RainH8/classic-trackball_1.5/hardware/Mechanicals-BTU-Mod/STL/Ploopy Classic V1.5 BTU/PloopyBTU_RevE_Buttons_main.stl

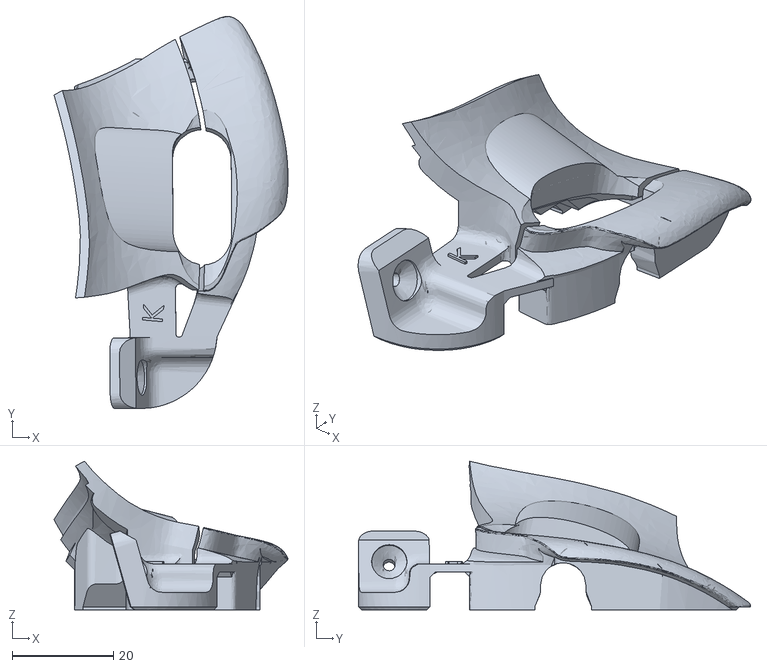
[picture p1: CAD file, 2026-01-17]
hardware/Mechanicals-BTU-Mod/STL/Ploopy Classic V1.5 BTU/PloopyBTU_RevE_Buttons_main.stl
46.3 x 77.6 x 29.4
