RainH8/classic-trackball_1.5/hardware/Mechanicals-BTU-Mod/STL/Ploopy Classic V1.5 BTU/PloopyBTU_RevE_Buttons_small.stl

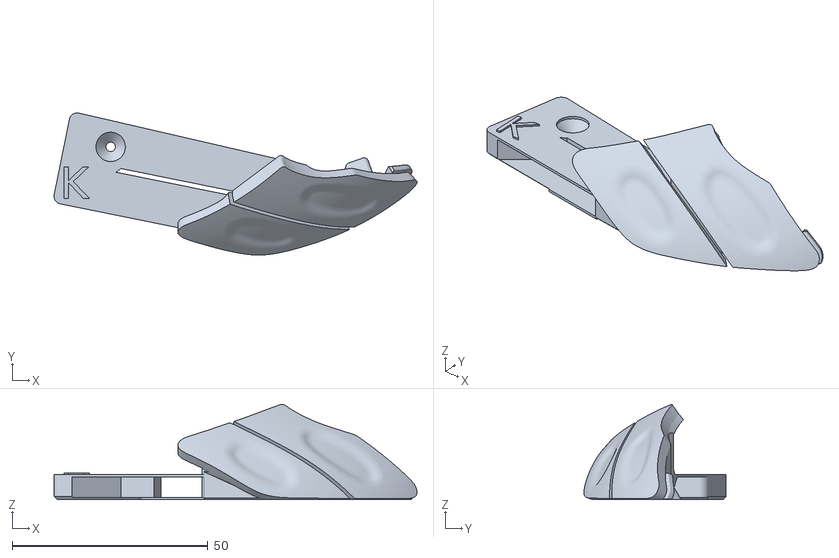
[picture p2: CAD file, 2026-01-17]
hardware/Mechanicals-BTU-Mod/STL/Ploopy Classic V1.5 BTU/PloopyBTU_RevE_Buttons_small.stl
92.8 x 36.3 x 24.3
