RainH8/classic-trackball_1.5/hardware/Mechanicals-BTU-Mod/STL/Ploopy Classic V1.5 BTU/PloopyBTU_RevE_Bottom_Shell-Wedge.stl

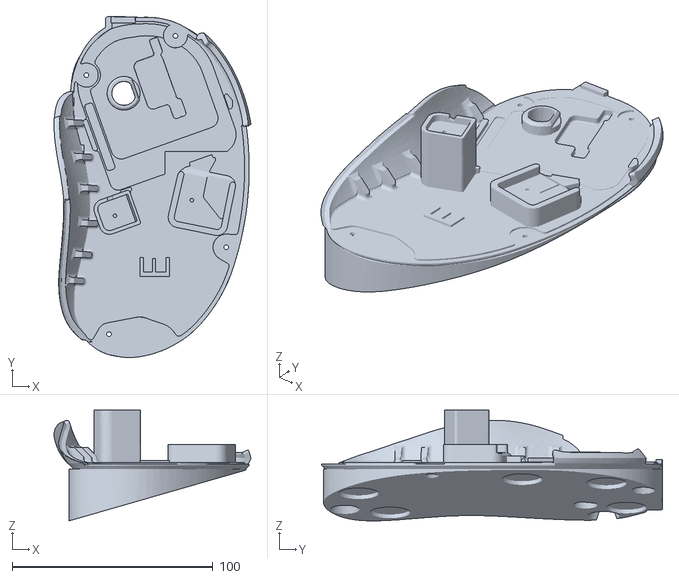
[picture p3: CAD file, 2026-01-17]
hardware/Mechanicals-BTU-Mod/STL/Ploopy Classic V1.5 BTU/PloopyBTU_RevE_Bottom_Shell-Wedge.stl
98.3 x 170.1 x 55.3
