RainH8/classic-trackball_1.5/hardware/Mechanicals-BTU-Mod/STL/Ploopy Classic V1.5 BTU/PloopyBTU_RevE_Bottom_Shell.stl

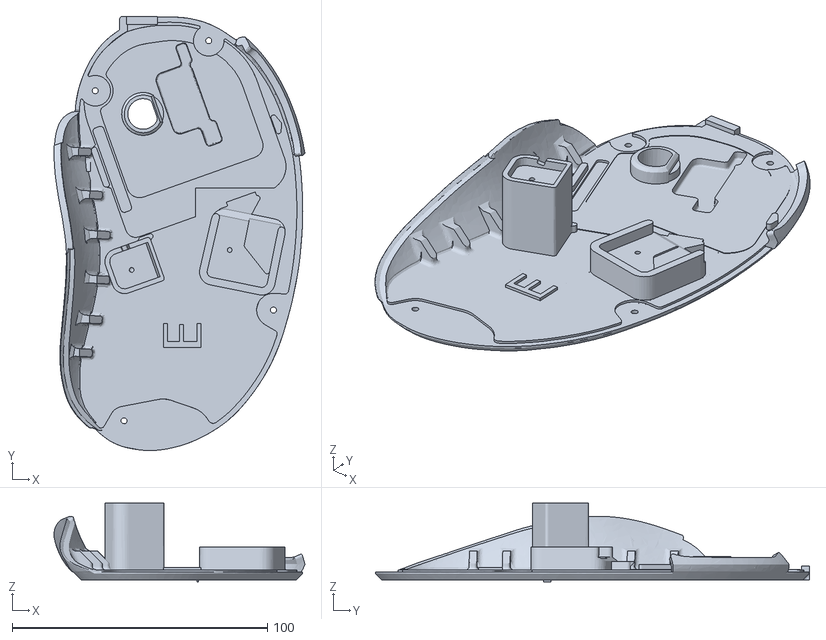
[picture p4: CAD file, 2026-01-17]
hardware/Mechanicals-BTU-Mod/STL/Ploopy Classic V1.5 BTU/PloopyBTU_RevE_Bottom_Shell.stl
98.3 x 170.0 x 30.8
