RainH8/classic-trackball_1.5/(commit log)

2026-01-17 Create Readme for Ploopy Classic V1.5 BTU mod
    Added detailed instructions and recommendations for the Ploopy Classic V1.5 BTU mod, including print settings and material suggestions.
2026-01-17 Added STL files of the Ploopy V1.5 BTU
    [PloopyBTU_RevE_Bottom_Shell-Wedge.stl, PloopyBTU_RevE_Bottom_Shell.stl, PloopyBTU_RevE_Buttons_main.stl, PloopyBTU_RevE_Buttons_small.stl]
